sscopazzi/Vessel_Measurement_Recorder/README.md

# Vessel Measurement Recorder
See overview PDF file for details. If you don't want to build your own, buy one from my buisness: [aspectwave.io/](https://www.aspectwave.io/store/p/vessel-measurement-recorder).

[placeholder image]
<!-- ![placeholder image](/images/VMR_placeholder.jpg) -->
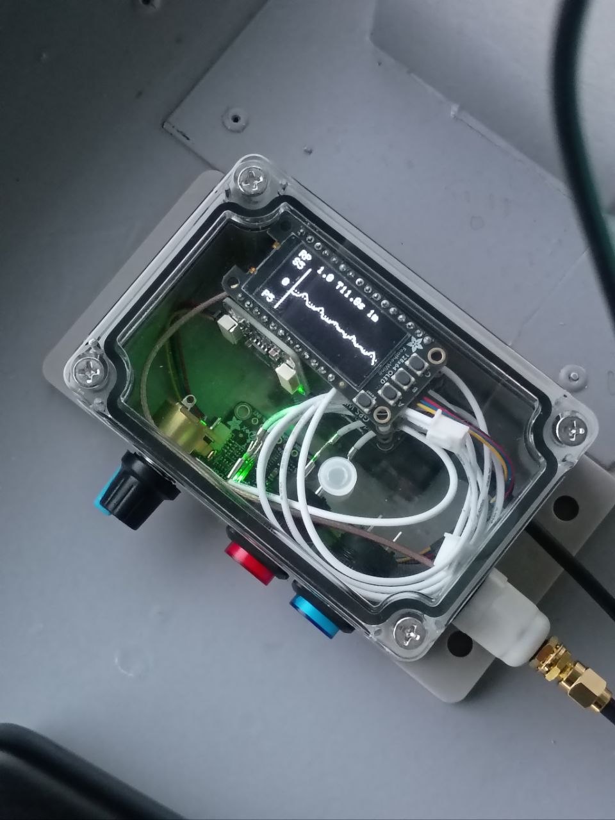
[picture p1: images/VMR_placeholder.jpg]


## Example Figures / Plots from VMR

All of the following figures were generated onboard a VMR (it can generate a plot even while logging, and even of the file that is open and logging) and downloaded to my phone before being uploaded here.

### Roll, Pitch, SOG, Roll Period
<!-- ![example graph](/images/20261106_192455Z.png) -->
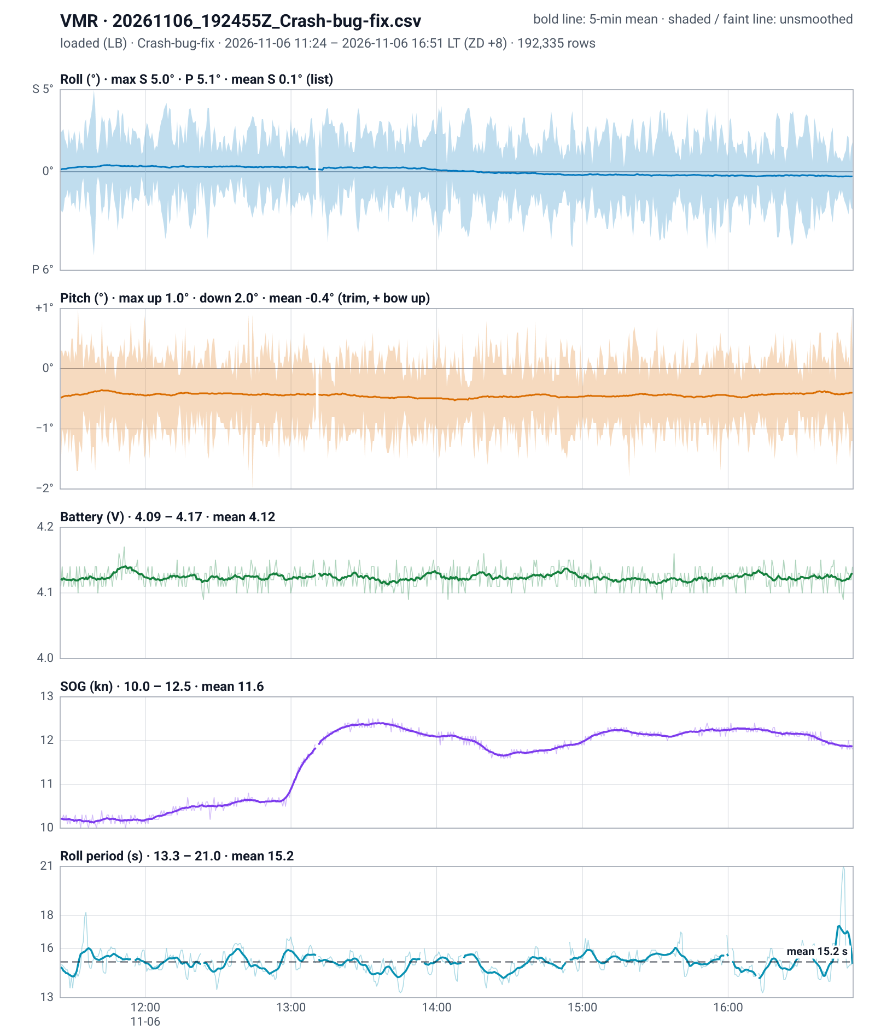
[picture p2: images/20261106_192455Z.png]


### Wave Spectrum
<!-- ![wave spectrum estimate](/images/VMR_waves_20261106_0532Z.png) -->
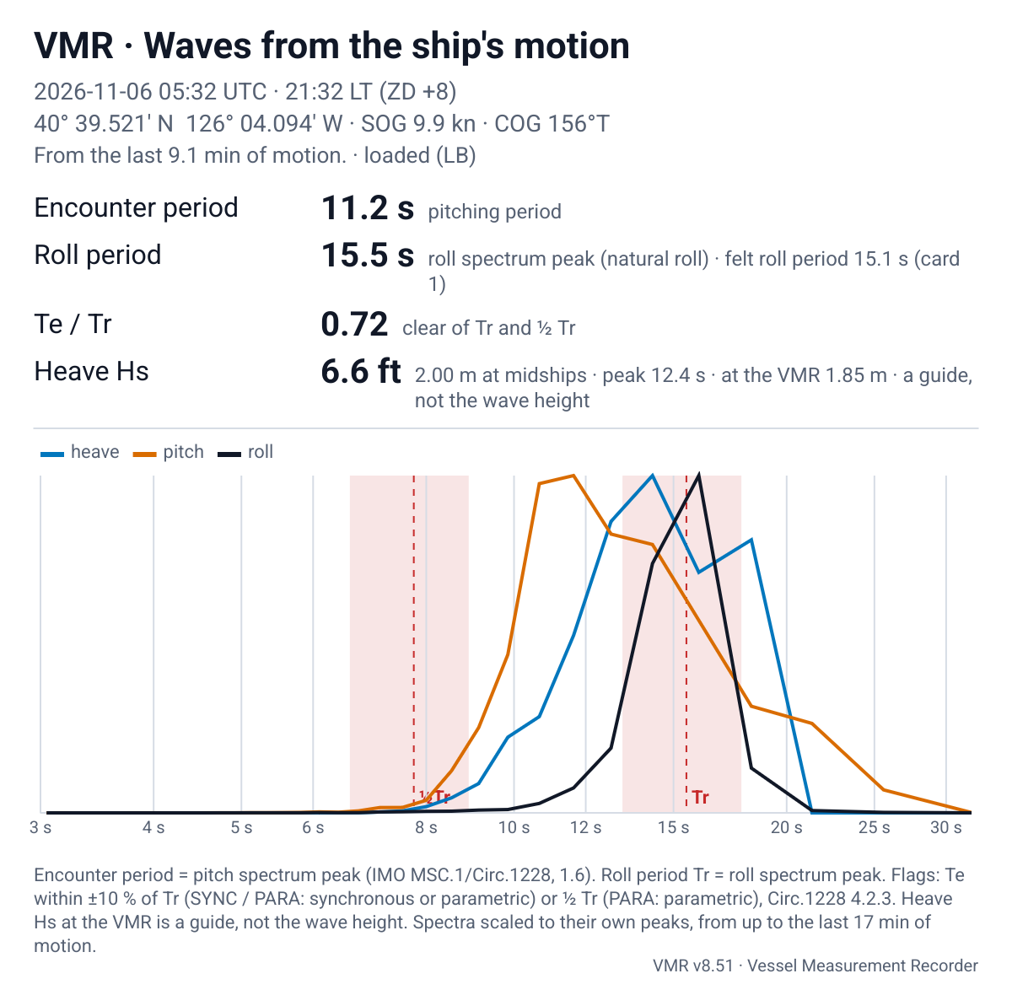
[picture p3: images/VMR_waves_20261106_0532Z.png]


### GM Estimate
<!-- ![GM estimate](/images/20261106_072238Z_GM.png) -->
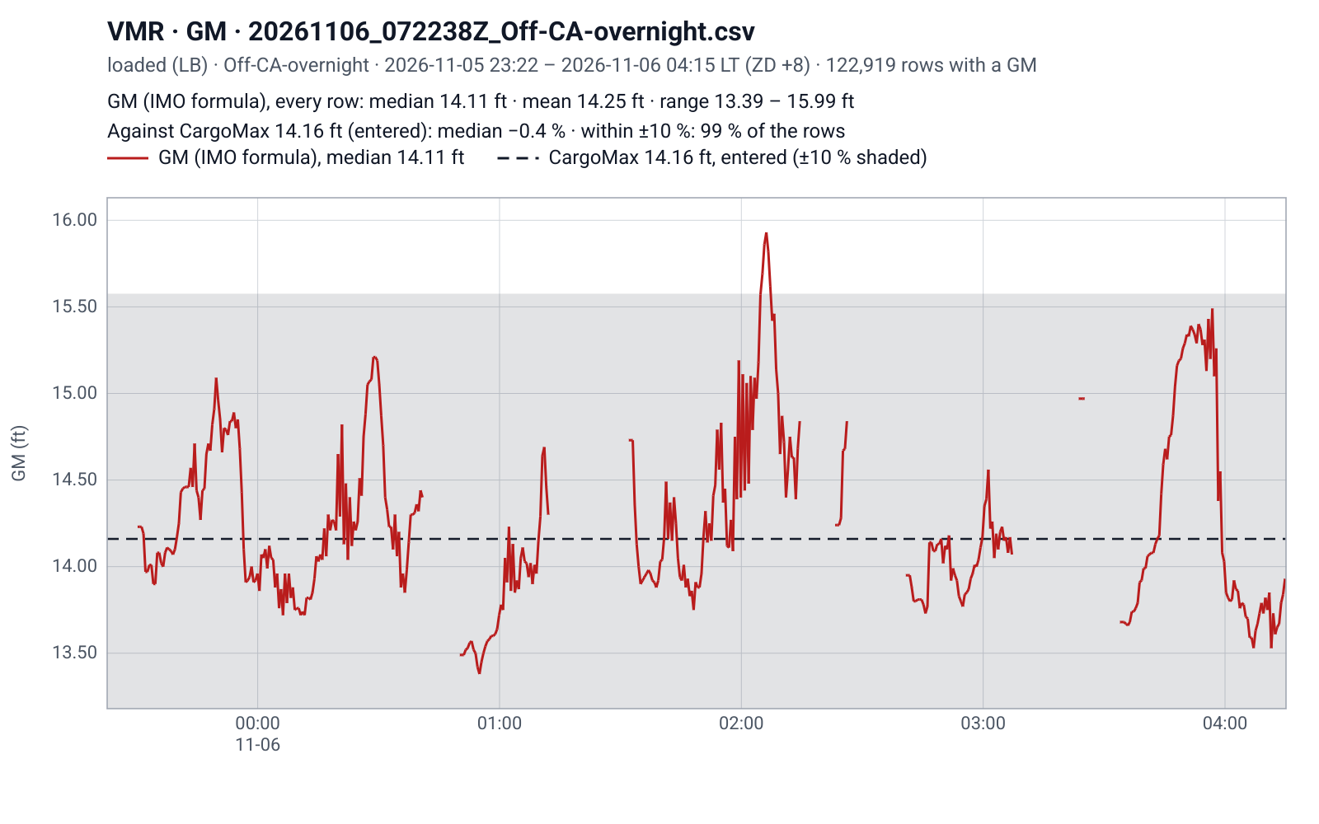
[picture p4: images/20261106_072238Z_GM.png]


## OLED Screens
The following are the current screens that can be viewed on the OLED (v8.56). They are rotated through with a physical button on the VMR or via selection on the Wi-Fi dashboard. 

<!-- ![OLED screens](/images/vmr_oled_screens-3.png) -->
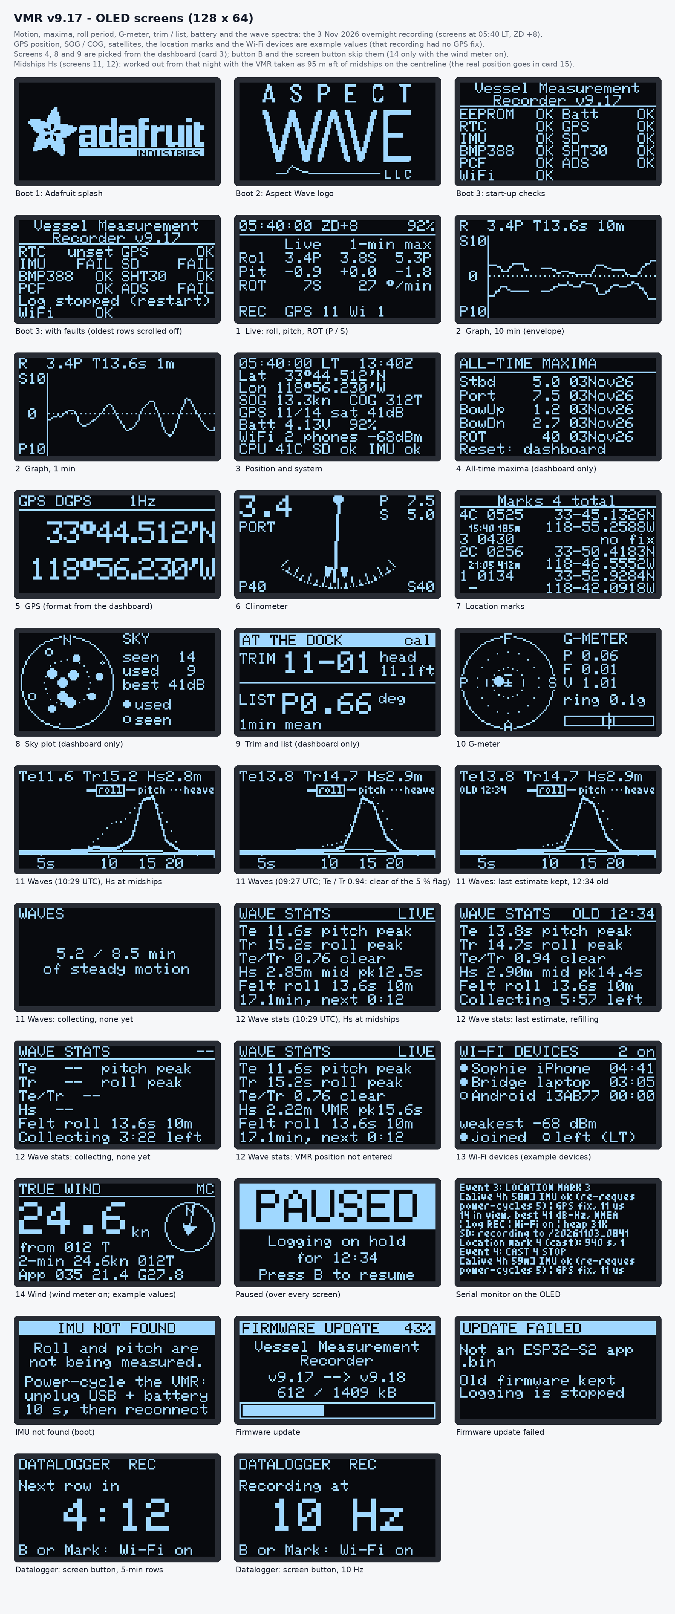
[picture p5: images/VMR_v9.17_OLED_screens.png]


## LCD Screens
The following are the current screens that can be viewed on the LCD (v9.x). By default, they are changed on the Wi-Fi Dashboard. If the system has no OLED (or it is disabled), they are changed with the screen button.

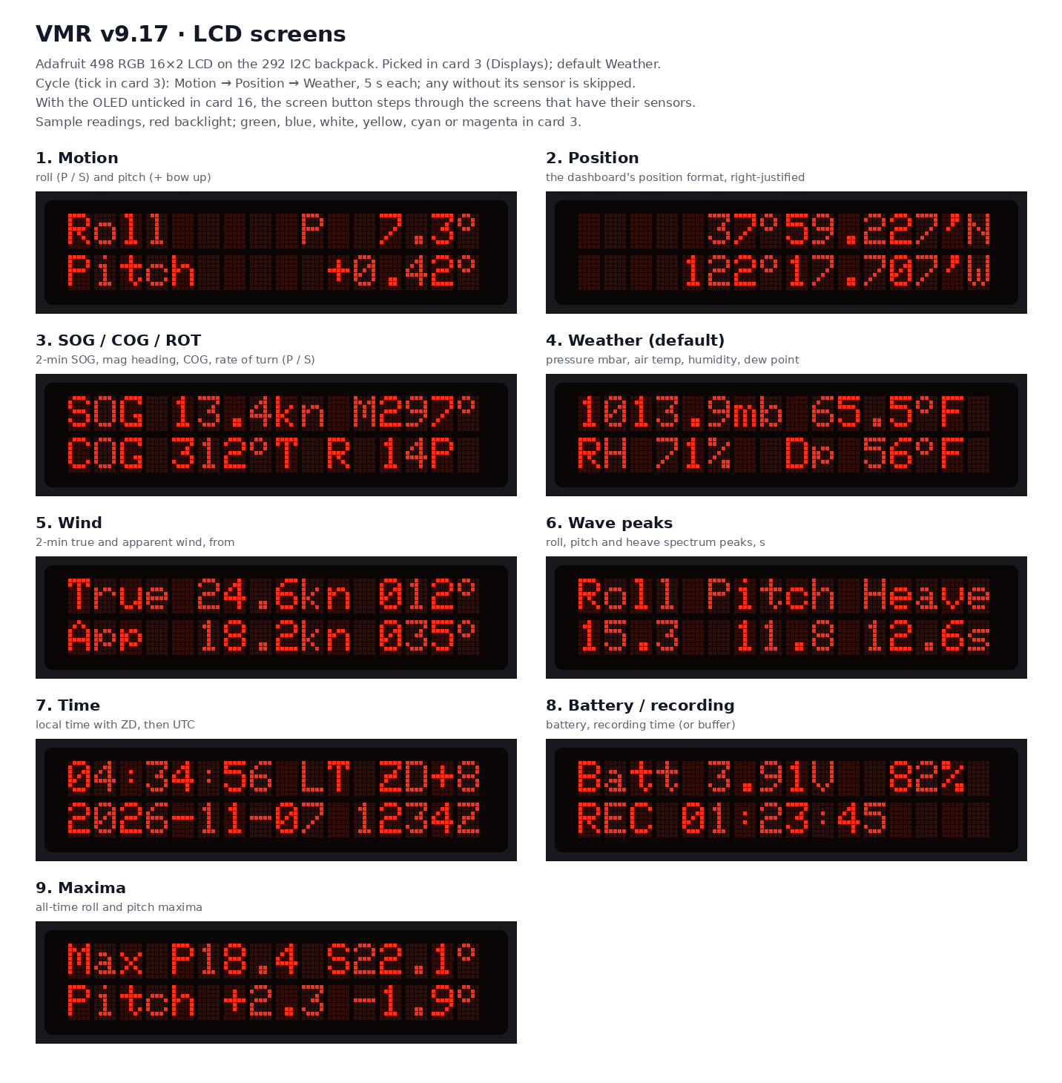
[picture p6: images/VMR_v9.17_LCD_screens.png]
