sscopazzi/Vessel_Measurement_Recorder/images/VMR_v9.17_wiring.png

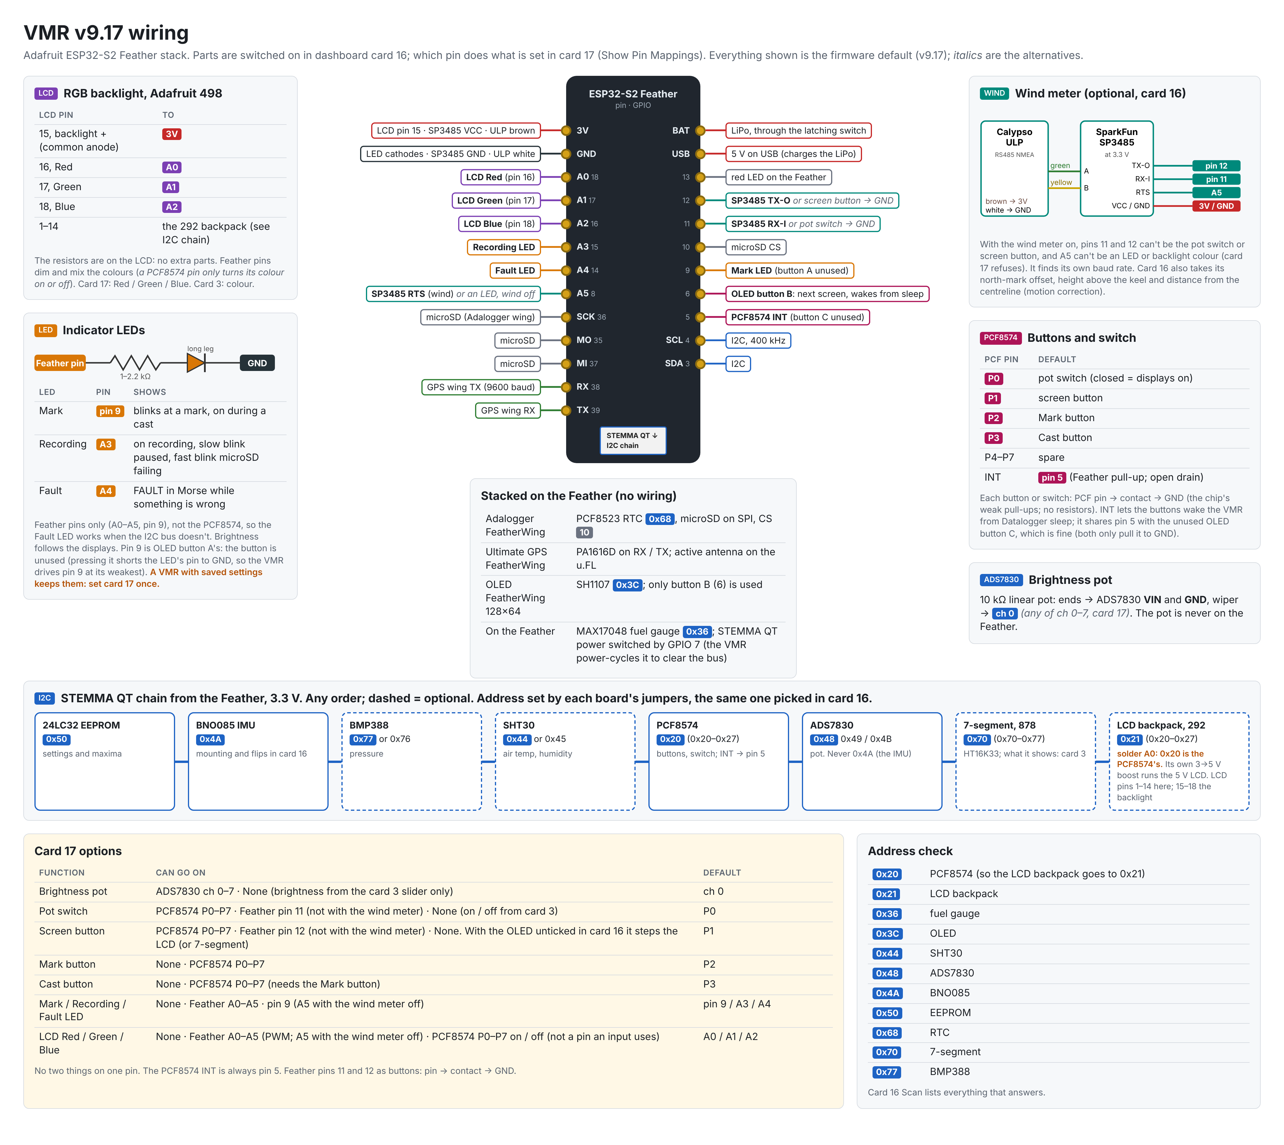
images/VMR_v9.17_wiring.png
