sscopazzi/Vessel_Measurement_Recorder/white_papers_and_testing/GM_testing/VMR_GM_Estimate_IMO_vs_Basic_Equation_v8.56.pdf

GM from the Roll Period: IMO vs Basic Formula· Aspect Wave LLC

A S P E C T W A V E L L C

# VMR: GM from Roll Period

Vessel Measurement Recorder · November 2026 · Prepared by Sophie Scopazzi

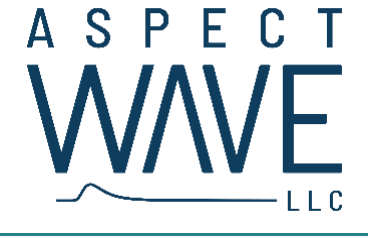
[picture p44: figure]

VMR data from Oct 31 and Nov 3 Nov 2026 (LT) · Alaskan Legend voyage 2613 (southbound leg), fully laden

Bottom line: the IMO formula the VMR uses came within 3% of CargoMax on both days (median), with 95 % of 479 values inside ±10%. The basic formula calculated GM 52–58 % high.

The Two Formulas

Both come from the free-rolling period of a ship, where k is the roll radius of gyration:

T =

2πk
√g · GM

Both of the following formula rearrange this equation to calculate GM from a measured roll period. They only differ in how they estimate the k value.

IMO (IS Code 2008, Part A 2.3) used by the VMR

T =

2CB
√GM

so GM = (

2CB
T

)

2
with
C = 0.373 + 0.023 B
d

− 0.043 L
100

Basic

T =

0.787B
√GM

so GM = (

0.787B
T

)

2

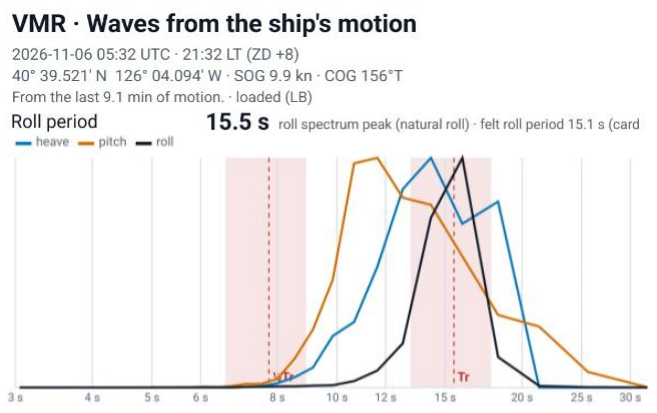
[picture p45: figure]

The VMR isolates the natural roll period by calculating the roll spectrum peak, found by running an FFT on the last 17 minutes of roll data and picking the highest bin, roll_tp_s (example seen above) for T roll period, in s. B beam. d mean draft. L waterline length (LBP when entered, as here, else LOA). GM metacentric height, all in m. C roll coefficient, ≈ k/B with g = 9.81 m/s².

Because 0.787 = 2 × 0.3935, the basic formula is the IMO formula with C fixed at 0.3935, meaning it assumes k ≈ 0.39 B for every ship and every loaded condition. The IMO formula works C out from the hull: it rises as the ship gets wider for its draft and falls as it gets longer. For the Alaskan Legend, voyage 2613 MMC Closed after loading in Valdez had C = 0.317.

Why the Basic Formula Reads High

GM goes with C². For the same roll period the two always differ by the same factor, whatever the sea state:

GMbasic

GMIMO

= (

0.3935
C

)

2
= (

0.3935
0.317 )

2
= 1.54

A C that is 24 % too large becomes a GM that is 54 % too large. The roll period does not separate them: both have GM ∝ 1/T², so a 1 s error at 15 s moves both by about 13 %.

Results

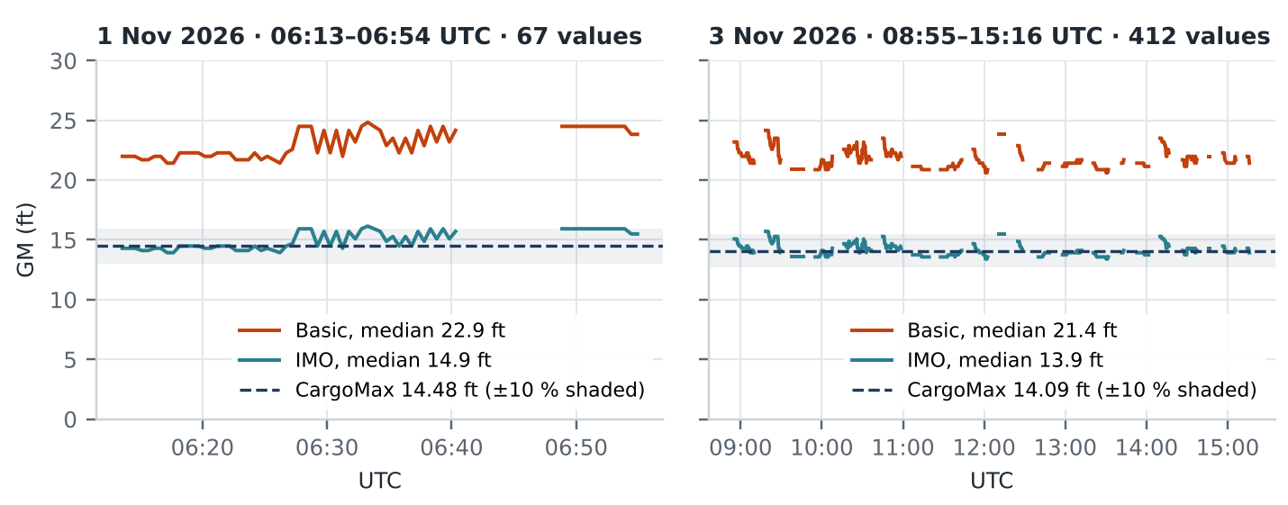
[picture p46: figure]

Figure 1. GM from each roll-period value with both formulas. Gaps are where the VMR logged no roll period; they are not bridged. Each calculated basic value is 1.54 × the IMO value at the same time. Ship observing ZD +8.

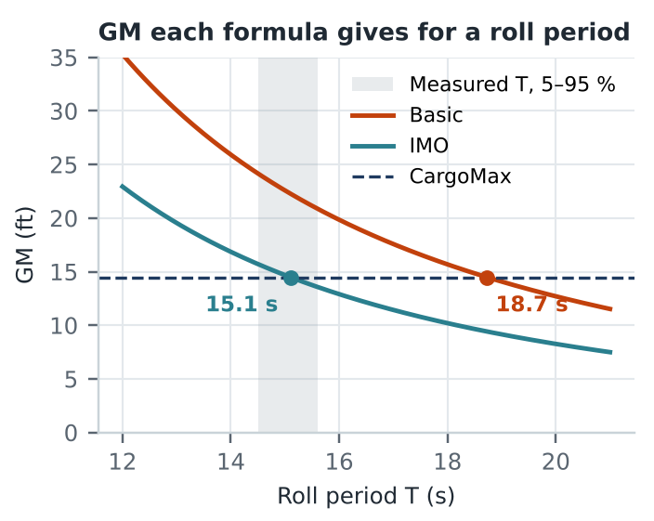
[picture p47: figure]
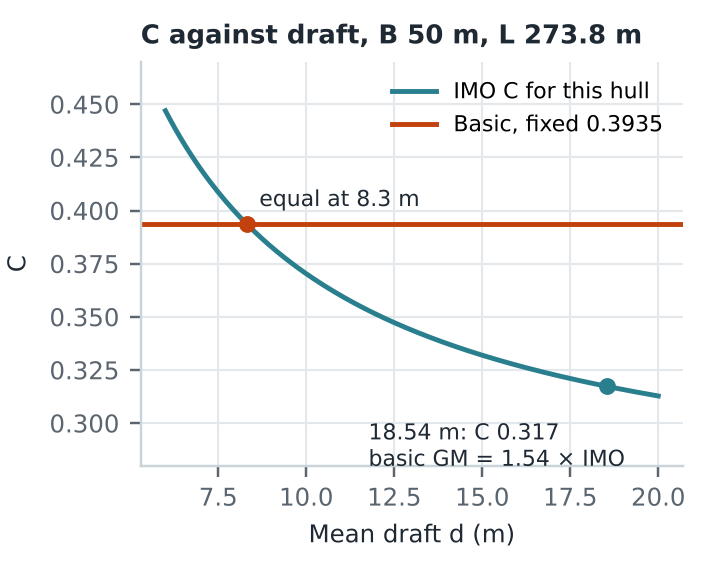
[picture p48: figure]

Figure 2. Left: GM against roll period, with the range the ship rolled at. Right: IMO C for this hull against draft.

Day (values) | Median T | CargoMax GM | IMO GM | IMO error | IMO within ±10 % | Basic GM | Basic error | Basic within ±10 %
1 Nov (67) | 14.9 s | 14.48 ft | 14.9 ft | +3 % | 72 % | 22.9 ft | +58 % | 0 %
3 Nov (412) | 15.4 s | 14.09 ft | 13.9 ft | −1 % | 99 % | 21.4 ft | +52 % | 0 %
Both (479) | 15.3 s | 14.14 ft | 14.1 ft | 0 % | 95 % | 21.7 ft | +54 % | 0 %

Table 1. Medians against CargoMax 14.48 ft (Nov 1) and 14.09 ft (3 Nov). Error = (median − CargoMax) / CargoMax; for Both, the median of each value’s error against its own day’s CargoMax. “Within ±10 %” counts every value.
Conclusion
- The IMO formula is a more accurate calculation of a vessel’s GM. It allows for the hull and its draft; the basic formula assumes one shape for every ship.
- The Vessel Measurement Recorder estimated the Alaskan Legend’s fully laden GM within 3% of the CargoMax calculated GM value.

Appendix: Where is k in the roll period formula?

In short. Neither formula drops k. Both fold it into the coefficient C, which is the roll radius of gyration as a fraction of the beam (C ≈ k/B). The basic formula fixes it; the IMO formula estimates it from the hull’s proportions.

The Starting Formula

A ship rolling freely at her natural period behaves like a pendulum. Its period is set by the roll radius of gyration k and the metacentric height:

T =

2πk
√g · GM

The above equation is standard naval architecture, not something the IS Code states. MSC.267(85) (the 2008 IS Code) only gives the approximate form T = 2CB/√GM, with no derivation.

Folding k into C

Write k as a fraction of the beam, k = (k/B)·B, and regroup:

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
The IMO formula has the form T = 2CB/√GM. Setting the two equal, B and √GM cancel:

C =

π
√g

·

k
B

= 1.003 k
B

so k ≈ C · B

With g = 9.81 m/s², π/√g = 1.003, so C and k/B are effectively the same number.

Why k Has to Be Estimated

The k that sets the roll period is not just the ship’s own mass distribution. It also includes the water the hull carries with it as it rolls (added mass), so it cannot be worked out from the loading computer’s weights. Both formulas therefore rely on a fitted value. The IS Code does not say where its C formula came from.

Sources
- IMO Resolution MSC.267(85), International Code on Intact Stability, 2008, Part A 2.3.4 (https://wwwcdn.imo.org/localresources/en/KnowledgeCentre/IndexofIMOResolutions/MSCResolutions/MSC.267(85).pdf)
- Vassalos, Jasionowski & Cichowicz, “Weather Criterion – Questions and Answers”, STAB 2003 (https://mail.shipstab.org/files/Proceedings/STAB/STAB2003/Papers/Paper%2055.pdf)

## MSC 85/26/Add.1 ANNEX 2 Page 15

## 2.3.4 The angle of roll (φ1)⁸ referred to in 2.3.1.2 shall be calculated as follows:

## where:

X1 | = factor as shown in table 2.3.4-1
X2 | = factor as shown in table 2.3.4-2
k | = factor as follows:

## k = 1.0 for round-bilged ship having no bilge or bar keels

## k = 0.7 for a ship having sharp bilges

## k = as shown in table 2.3.4-3 for a ship having bilge keels, a bar keel or both

## r = 0.73 + 0.6 OG/d

## with:

## OG = KG ñ d

d | = mean moulded draught of the ship (m)
s | = factor as shown in table 2.3.4-4, where T is the ship roll natural period. In absence of sufficient information, the following approximate formula

## can be used:

Rolling period | ( ) 2 * *
s
GM

C B

## T = where:

C = 0.373 + 0.023(B/d) - 0.043(Lwl/100). The symbols in tables 2.3.4-1, 2.3.4-2, 2.3.4-3 and 2.3.4-4 and the formula for the

## rolling period are defined as follows:

## Lwl = length of the ship at waterline (m)

B | = moulded breadth of the ship (m)
d | = mean moulded draught of the ship (m)
8 | The angle of roll for ships with anti-rolling devices should be determined without taking into account the operation of these devices unless the Administration is satisfied with the proof that the devices are effective even with sudden shutdown of their supplied power.
1 | 109 | 1 | 2 φ = | * k * X * X * r * s (degrees)

This k value is a bilge keel factor;

## different than then k value used throughout this document

## MSC 85/26/Add.1 ANNEX 2 Page 16

CB | = block coefficient (-)
Ak | = total overall area of bilge keels, or area of the lateral projection of the bar keel, or sum of these areas (m²)

GM = metacentric height corrected for free surface effect (m). Table 2.3.4-1 ñ Values of factor X1

B/d | X1
≤ 2.4 | 1.0
2.5 | 0.98
2.6 | 0.96
2.7 | 0.95
2.8 | 0.93
2.9 | 0.91
3.0 | 0.90
3.1 | 0.88
3.2 | 0.86
3.4 | 0.82
≥ 3.5 | 0.80

## Table 2.3.4-2 ñ Values of factor X2

CB | X2
≤ 0.45 | 0.75
0.50 | 0.82
0.55 | 0.89
0.60 | 0.95
0.65 | 0.97
≥ 0.70 | 1.00

## Table 2.3.4-3 ñ Values of factor k

×100 A k L B × WL | k
0 | 1.0
1.0 | 0.98
1.5 | 0.95
2.0 | 0.88
2.5 | 0.79
3.0 | 0.74
3.5 | 0.72
≥ 4.0 | 0.70

## Tables not used or required

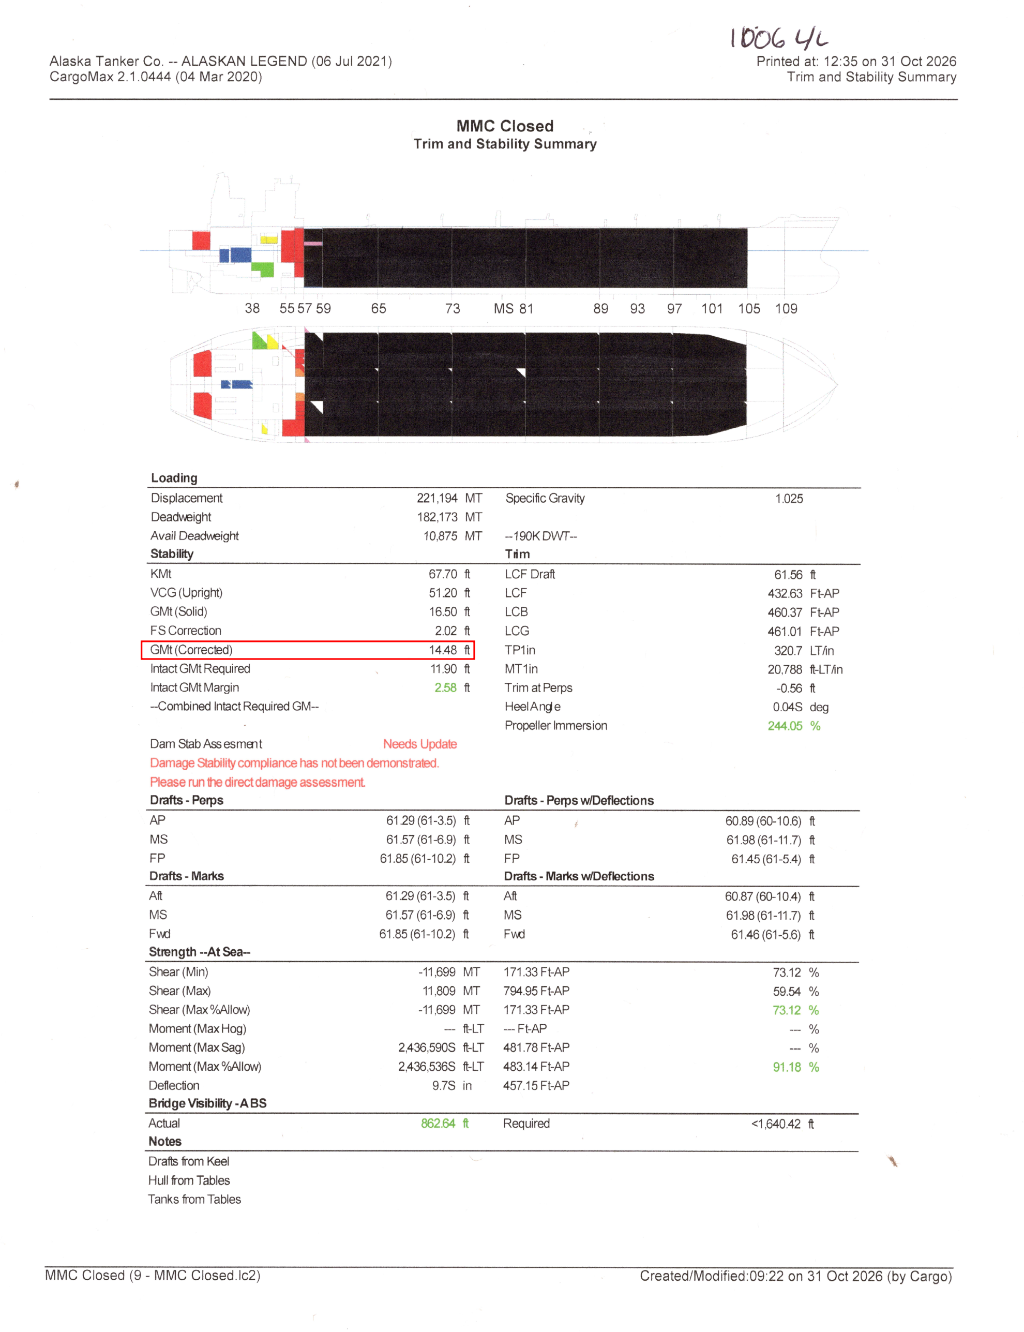
[picture p49: page 6]
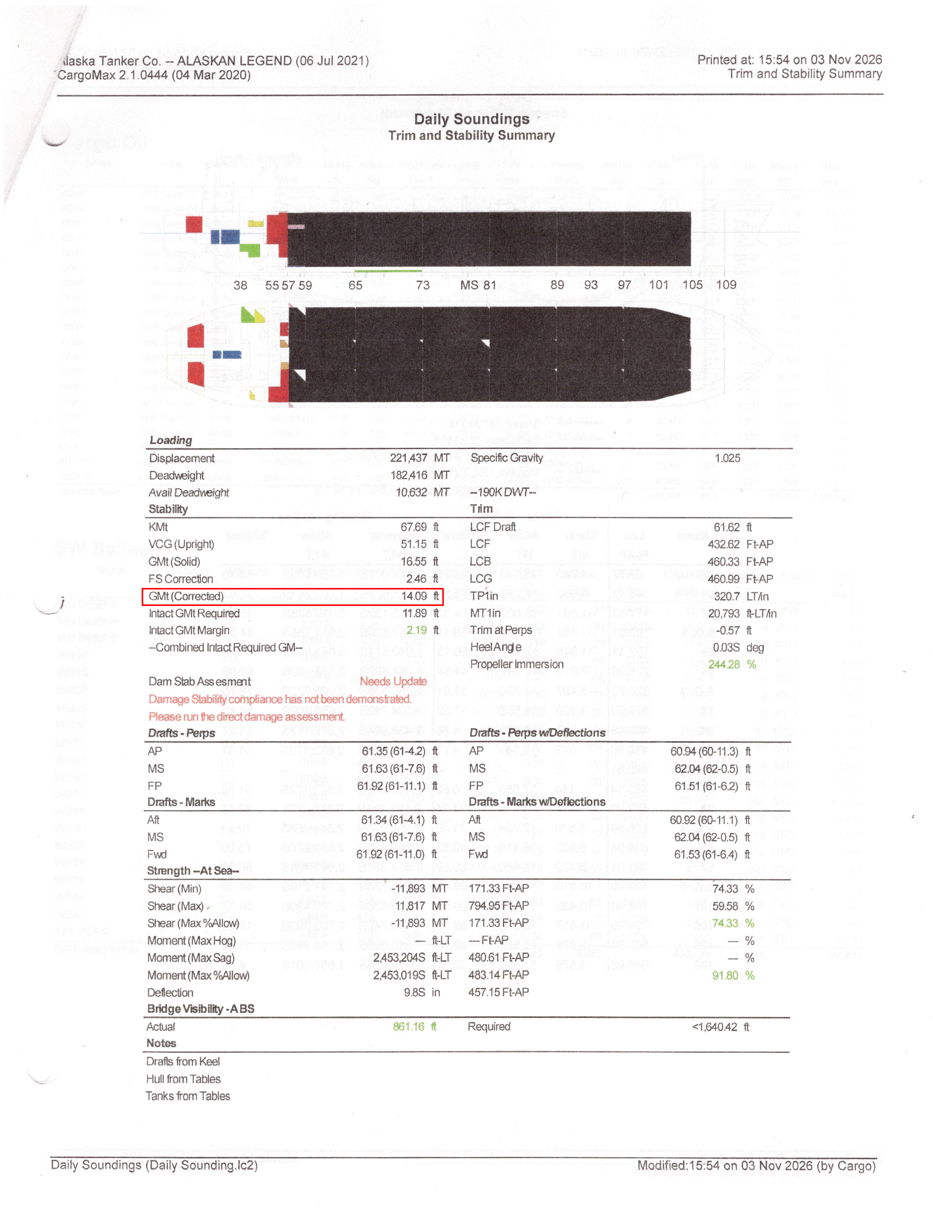
[picture p50: page 7]
