sscopazzi/Vessel_Measurement_Recorder/white_papers_and_testing/GM_testing/DATA/data/20261101_061109Z.csv

# Vessel Motion Recorder (VMR)
# firmware_version | 5.5
# firmware_build | Oct 31 2026 23:02:17
# credits | Written by Aspect Wave LLC (Sophie Scopazzi) and Claude (Anthropic) 2026
# device_id | F7C4B0
# file | 20261101_061109Z.csv
# file_split | one file for the whole recording
# name
# condition | loaded (LB)
# start_utc | 2026-11-01T06:11:09Z
# time_source | GPS
# zone_description | +8 (UTC = LT + ZD)
# log_rate_hz | 10
# gps_rate_hz | 1
# imu | BNO085 game rotation vector (no magnetometer) 50 Hz over I2C
# axes | X to bow / roll + = starboard down / pitch + = bow up / yaw relative (+ = clockwise) / yaw_rate + = turning to starboard
# level_zero | off (raw sensor angles)
# ship_beam_m | 50.00
# ship_loa_m | 286.90
# ship_lbp_m | 273.80
# ship_parallel_wl_m | 119.70
# ship_draft_fwd_m | 18.59 (61-00)
# ship_draft_mid_m | 18.87 (61-11)
# ship_draft_aft_m | 18.49 (60-08)
# ship_draft_mean_m | 18.54 (60-10)
# ship_keel_to_main_deck_m | 28.00
# ship_keel_to_bridge_m | 45.80
# ship_keel_to_top_m | 52.30
# ship_block_coef | 0.800
# ship_waterplane_coef
# ship_tpi_lt_per_in | 320.7
# ship_displacement_lt | 221190
# ship_gm_loading_computer_ft | 14.48
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
