sscopazzi/Vessel_Measurement_Recorder/(commit log)

2026-11-07 GM test figures
    [20261101_061109Z.csv, 20261103_084137Z_New-GM.csv]
2026-11-07 rename and upload ino and binary
    [partitions.csv]
2026-11-07 fix file suffix
    [20261103_084137Z.csv]
